MarkChuCarroll/instruments/README.md

# instruments
OpenSCAD models of musical instruments
