MarkChuCarroll/instruments/tenor/mtenor-out-fretboard-full.stl

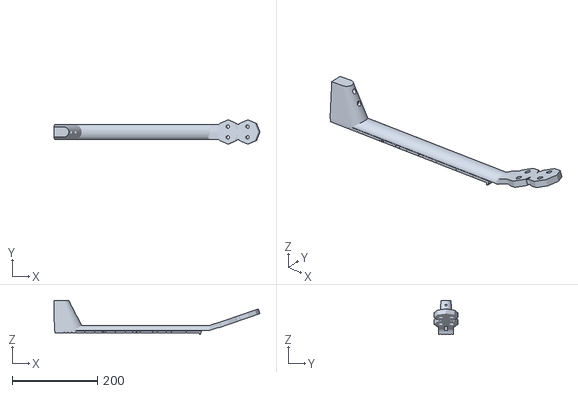
[picture p2: CAD file, 2025-11-11]
tenor/mtenor-out-fretboard-full.stl
484.5 x 56.0 x 80.5
