MarkChuCarroll/instruments/tenor/mtenor-out-assembled.stl

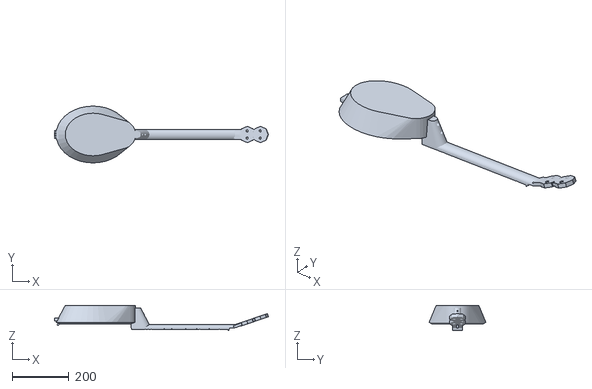
[picture p3: CAD file, 2025-11-11]
tenor/mtenor-out-assembled.stl
753.2 x 200.0 x 89.5
