MarkChuCarroll/instruments/tenor/mtenor-out-neck-a.stl

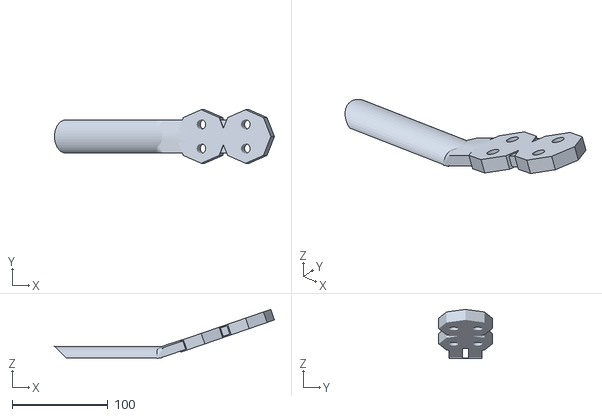
[picture p4: CAD file, 2025-11-11]
tenor/mtenor-out-neck-a.stl
230.0 x 56.0 x 51.5
