MarkChuCarroll/instruments/tenor/mtenor-out-bridge.stl

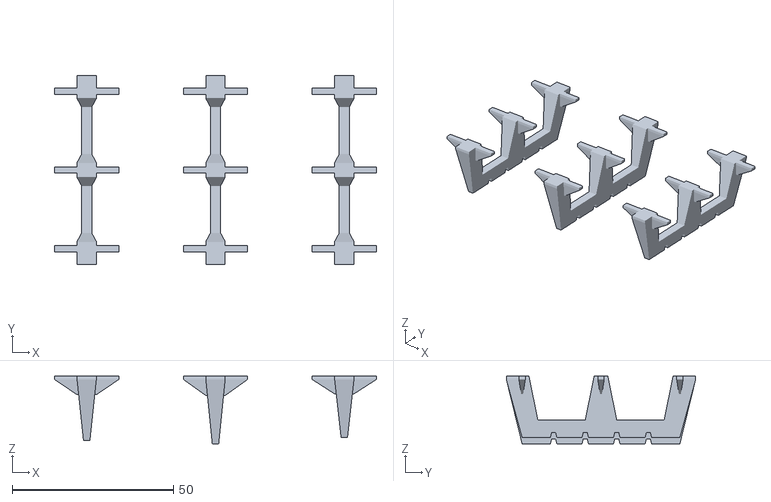
[picture p5: CAD file, 2025-11-11]
tenor/mtenor-out-bridge.stl
100.0 x 58.8 x 21.0
