MarkChuCarroll/instruments/tenor/mtenor-out-body-tail.stl

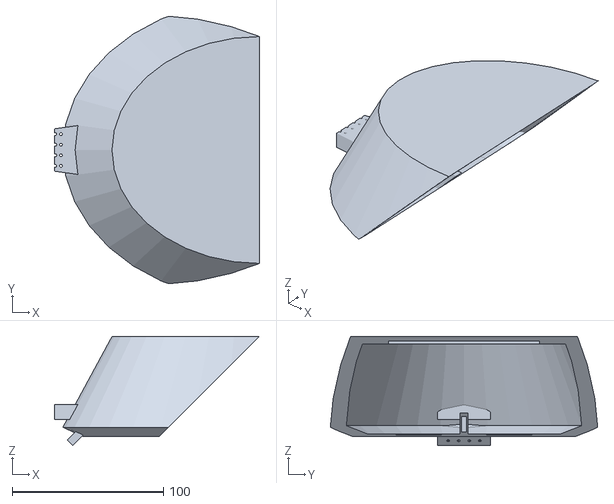
[picture p6: CAD file, 2025-11-11]
tenor/mtenor-out-body-tail.stl
135.5 x 176.8 x 72.1
