MarkChuCarroll/instruments/tenor/mtenor-out-body-neck.stl

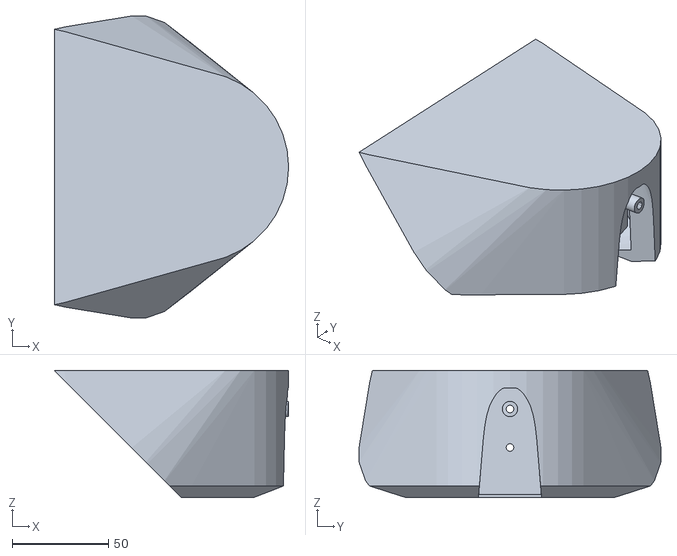
[picture p7: CAD file, 2025-11-11]
tenor/mtenor-out-body-neck.stl
121.7 x 156.9 x 66.0
