MarkChuCarroll/instruments/tenor/mtenor-out-body-center.stl

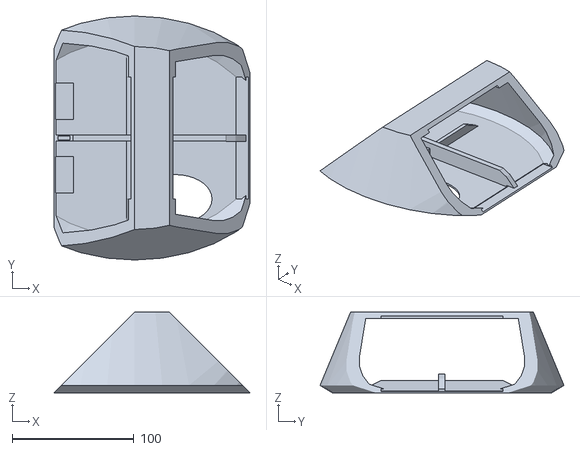
[picture p8: CAD file, 2025-11-11]
tenor/mtenor-out-body-center.stl
160.3 x 200.0 x 66.0
