MarkChuCarroll/instruments/tenor/mtenor-out-misc_bits.stl

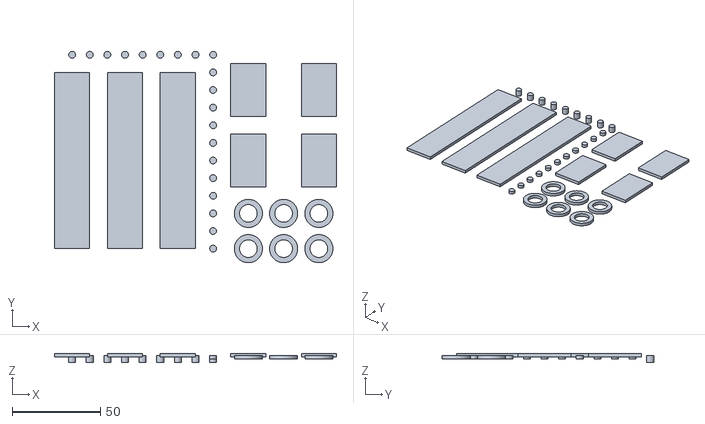
[picture p9: CAD file, 2025-11-11]
tenor/mtenor-out-misc_bits.stl
160.0 x 120.0 x 5.00
