MarkChuCarroll/instruments/tenor/mtenor-out-fretboard-a.stl

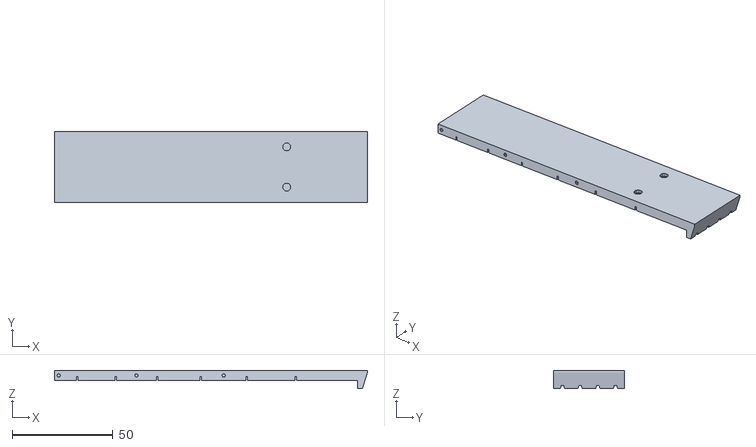
[picture p10: CAD file, 2025-11-11]
tenor/mtenor-out-fretboard-a.stl
155.0 x 35.0 x 9.00
