MarkChuCarroll/instruments/tenor/mtenor-out-neck-c.stl

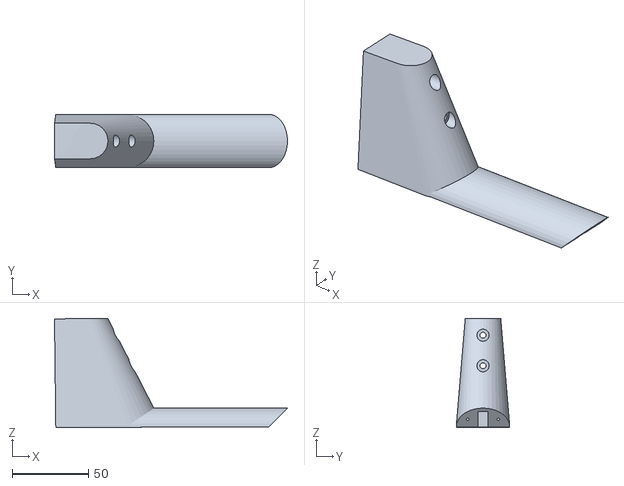
[picture p11: CAD file, 2025-11-11]
tenor/mtenor-out-neck-c.stl
152.7 x 35.0 x 71.5
