MarkChuCarroll/instruments/tenor/mtenor-out-neck-b.stl

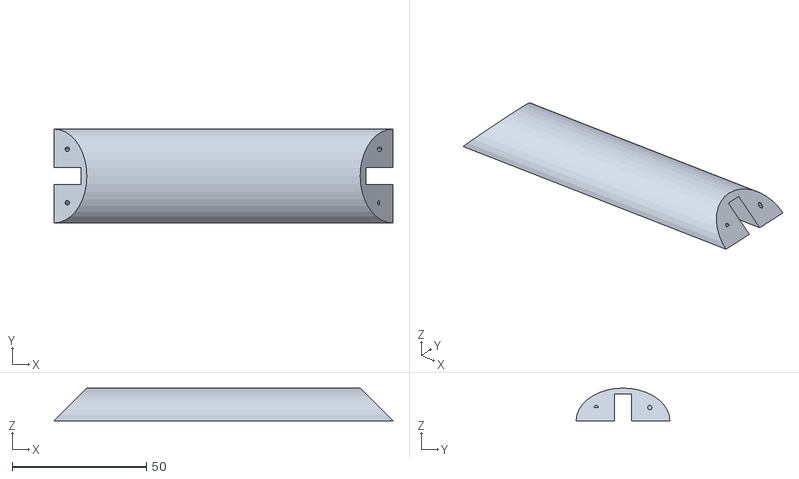
[picture p12: CAD file, 2025-11-11]
tenor/mtenor-out-neck-b.stl
126.4 x 35.0 x 12.2
