MarkChuCarroll/instruments/tenor/mtenor-out-fretboard-b.stl

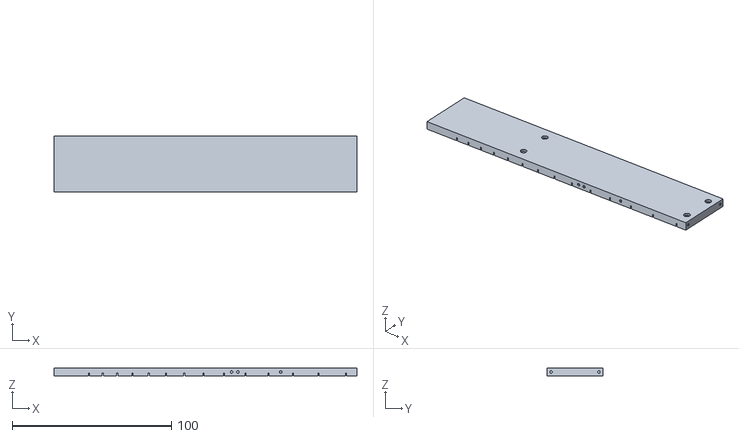
[picture p13: CAD file, 2025-11-11]
tenor/mtenor-out-fretboard-b.stl
190.1 x 35.0 x 5.00
