MarkChuCarroll/instruments/tenor/mtenor-out-lower-fretboard.stl

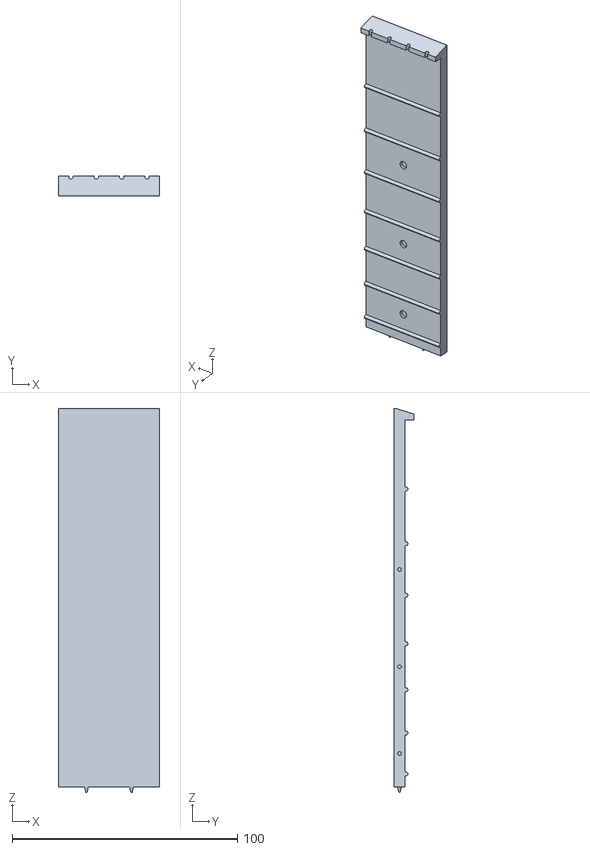
[picture p14: CAD file, 2025-02-17]
tenor/mtenor-out-lower-fretboard.stl
45.0 x 9.00 x 170.4
