MarkChuCarroll/instruments/tenor/bosl-tenor.scad

//
// Copyright 2024 Mark C. Chu-Carroll
//
// Licensed under the Apache License, Version 2.0 (the "License");
// you may not use this model except in compliance with the License.
// You may obtain a copy of the License at
//
//     http://www.apache.org/licenses/LICENSE-2.0
//
// Unless required by applicable law or agreed to in writing, software
// distributed under the License is distributed on an "AS IS" BASIS,
// WITHOUT WARRANTIES OR CONDITIONS OF ANY KIND, either express or implied.
// See the License for the specific language governing permissions and
// limitations under the License.

include <BOSL2/std.scad>

/**
 * The body is teardrop shaped. It's built by setting up two
 * cylinders, one smaller than the other, with offset centers,
 * and then taking their hull. We add a bit of slant by making
 * the larger cylinder actually a bit conic, but square up at
 * the heel because the smaller is a true cylinder.
 * Then we round the edges by using minkowski sum with a little sphere.
 */

module body(size, thickness, split = false) {
  module body_shape(length, thickness) {
    // Anchoris the body top where the neck meets the body.
    //  translate([ 130, 0, -5 ])
    //  minkowski() {
    module outline() {
      hull() {
        scale([ 1.3, 1, 1 ]) {
          cylinder(thickness + 10, length, length * 3 / 4);
        }
        translate([ length, 0, 0 ]) {
          cylinder(thickness + 10, length / 2, length / 2);
        }
      }
    }

    translate([ 0, 0, -5 ]) {
      hull() {
        outline();
        translate([ 0, 0, -10 ]) scale([ 0.9, 0.9, 0.9 ]) outline();
      }
    }
  }

  /**
   * The screwblock is a section matching the back end of the neck's heel
   * block, which has holes and hex-nut slots to allow the neck to be
   * securely bolted on to the body.
   */
  module screwblock(radius, length, thickness) {
    /*
     * I want to put cutouts for hex nuts into the screw block.
     * For an m4 hex nut, the size flat-to-flat is 7mm.
     * So the rough outer radius of the hexnut is 5mm.
     */
    module hexnut_slot() {
      rotate([ 90, 0, 0 ]) {
        rotate([ 0, 0, 30 ]) {
          union() {
            translate([ 0, 0, 20 ]) {
              cylinder(40, 2.4, 2.4, center = true, $fn = 20);
            }
            linear_extrude(height = 3) { circle(5, $fn = 6); }
          }
        }
      }
    }

    // positions for the holes are 8mm from the base of the neck heel,
    // and 25mm from the base of the neck heel.
    // The neck heal is ??? mm off the bottom of the body.
    translate([ size * 1.2 + 14, 0, thickness * 0.8 + 5 ])
        rotate([ 0, 180, 90 ]) {
      elev = thickness * 0.8 + 5 + 1;

      difference() {
        linear_extrude(thickness + 11, scale = [ 1.5, 1 ], center = false) {
          translate([ -radius, 0, 0 ]) { square([ radius * 2, length / 2 ]); }
        }
        // formerly 16.8 and 28.8
        translate([ 0, length / 2, elev - 8 ]) hexnut_slot();
        translate([ 0, length / 2, elev - 25 ]) hexnut_slot();
      }
    }
  }

  module assembly() {
    union() {
      /**
       * We want the body to be hollow. So what we do is create
       * one copy of the body  form, and then a second scaled version that's a
       * bit smaller - and we subtract the smaller one from the larger.
       */

      difference() {
        body_shape(size, thickness);
        translate([ 0, 0, 1 ]) {
          scale([ 0.9, 0.9, 0.9 ]) { body_shape(size, thickness); }
        }

        // cut out the sound-hole.
        // TODO: don't cut so far down; it's cutting into the body side.
        move([ size / 2.0 - 5, -size / 2 + 5, -thickness / 2 ]) {
          scale([ 1.4, 1.0, 1.0 ]) { cylinder(size / 4, size / 4, size / 4); }
        }

        translate([ 0, 0, -20 ]) neck(neck_offset, scale, neck_width, true);
      }

      translate([ -20, 0, 0 ]) screwblock(neck_width * 2 / 6, 20, 45);

      // and the tailpiece.
      up(thickness / 3) left(size * 1.1) tapered_tailpiece(
          neck_width, neck_width / 4, neck_width / 1.5, neck_width / 6);

      // The string guide over the tailpiece.
      color("#ff00ff") translate([ -size * 1.25, 0, -12 ]) rotate([ 0, 45, 0 ])
          cuboid([ 2, neck_width * 1.2, 14 ], chamfer = 1);

      // internal bracing
      // CF rod is 1/8x3/8 - which is 3.175mmx9.525mm. Adding a bit of space
      // so that it can be slid in, we can make a slot that's 3.5mmx10mm.
      difference() {
        union() {
          down(12) color("#ff0000") prismoid([ 10, 155 ], [ 10, 120 ], 6);
          zrot(90) down(12) fwd(100) left(6) cube([ 12, 200, 15 ]);
        }
        zrot(90) down(7) fwd(95) left(3.5 / 2) cube([ 3.5, 190, 10 ]);

        // prismoid([ 12, 200 ], [ 10, 150 ], 15);
        // prismoid([ 3.5, 200 ], [ 3.5, 150 ], 10);
      }
    }
  }

  assembly();
}

/*
 * The neck gets pretty complicated.
 * We start with a half cylinder of the right length. To get the cross
 * section that we want, we then stretch its width by 1.3, and its
 * height and 1.2.
 *
 * Then we add the head. It'll probably get tweaked a bit to make it
 * prettier, but for now, it's a box set at a 20 degree declination
 * from the next, rounded at the back.
 *
 * Next, we add a heel, which I moved into another module.
 *
 * After the heel, we'll add the nut up at the top of the neck.
 *
 * Right next to the nut will be the fingerboard, with fret slots. (I
 * strongly prefer real  metal frets, so I'm just using slots, not
 * creating printed frets.
 */
module neck(offset, scale, width, solid = false) {
  neck_length = scale - offset;
  thickness = width / 2;

  /*
   * For creating the neck, it'll make things easier to start
   * with a half-cylinder.
   */
  module half_cylinder(radius, length) {
    union() {
      difference() {
        rotate([ 0, 90, 0 ]) { cylinder(length, radius, radius); }
        translate([ 0, -radius, -radius ]) {
          cube([ length * 3, radius * 2, radius ]);
        }
      }
    }
  }

  module neck_blank(width, length) {
    scale([ 1, 1.0, 0.8 ]) { half_cylinder(width / 2.0, length); }
  }

  module trussrod_cutout(length, neckwidth) {
    one_eighth_inch = 25.4 / 8;
    three_eighths_inch = 3 * one_eighth_inch;
    one_quarter_inch = one_eighth_inch * 2;
    one_sixteenth_inch = one_eighth_inch / 2;
    five_sixteenths_inch = 5 * one_sixteenth_inch;
    union() {
      // The main trussrod slot, running the full length of the neck.
      translate([ 0, -one_eighth_inch, -20 ])
          cube([ length, one_quarter_inch, three_eighths_inch + 20 ]);

      // The trussrod gets a little bit wider at the top, where the
      // screw mechanism is, so we need to broaden the cutout just
      // a little bit.
      translate([ length - 45, -three_eighths_inch / 2, -18 ]) {
        cube([ 45, three_eighths_inch, three_eighths_inch + 22 ]);
      }
      // And to reduce stress concentration, add a transition
      // between the wider and narrower parts.
      translate([ length - 45 + 1, 0, -0.5 ]) {
        color("#008888") rotate([ 0, -90, 0 ])
            prismoid(size1 = [ 29, three_eighths_inch ],
                     size2 = [ 20, one_quarter_inch ], h = three_eighths_inch);
      }

      translate([ length, 0, 4 ]) {
        rotate([ 0, 90, 0 ]) {
          scale([ 1.2, 1.6, 1.0 ]) cylinder(40, neckwidth / 5, neckwidth / 8);
        }
      }
    }
  }

  module heel(radius, length, thickness, drill = true) {
    translate([ radius - 5, 0, thickness ]) difference() {
      rotate([ 180, 0, 0 ]) {
        difference() {
          linear_extrude(thickness, scale = [ 2.0, 1.5 ], center = false) {
            circle(radius) left(radius) square(radius * 2, thickness);
          }
          translate([ -6 * radius, -radius * 2, 0 ]) {
            cube([ radius * 4, radius * 4, thickness ]);
          }

          if (drill) {
            translate([ -20, 0, 8 ]) {
              rotate([ 0, 90, 0 ]) { cylinder(70, 2.4, 2.4, $fn = 20); }
            }
            translate([ 10, 0, 8 ]) {
              rotate([ 0, 90, 0 ]) { cylinder(30, 5, 5); }
            }

            translate([ -20, 0, 25 ]) {
              rotate([ 0, 90, 0 ]) { cylinder(70, 2.4, 2.4, $fn = 20); }
            }
            translate([ 12, 0, 25 ]) {
              rotate([ 0, 90, 0 ]) { cylinder(30, 5, 5); }
            }
          }
        }
      }
    }
  }

  /**
   * The headstock.
   *
   * This took a ton of time to get to the point where it looks
   * good, and it's also functional. It's basically shaped from
   * two overlapping octagons. It gets thicker and a bit faceted
   * as it comes close to the neck joint.
   */
  module headstock(length, width, thickness) {
    // Anchor point is the center edge of the round section where the
    // headstock meets the body.

    module oct(diam) {
      intersection() {
        square([ diam, diam ], center = true);
        rotate([ 0, 0, 45 ]) square([ diam, diam ], center = true);
      }
    }

    module shaped_head(width, thickness) {
      rotate([ 0, 0, 90 ]) {
        union() {
          back(10) left(10) down(2) mark(width / 4, 4);
          linear_extrude(thickness) {
            // Overlapp two of the octagons.
            oct(width);
            translate([ 0, 3 * width / 4, 0 ]) {
              scale([ 1.0, 1.0, 1.0 ]) oct(width);
            }
            //            // And then add in a rectangular segment to push them
            //            back. translate([ -width / 4, 5 * width / 4, 0 ]) {
            //              square([ width / 1.5, 20 ]);
            //            }
          }
        }
      }
      // for the area where the head meets the neck joint,
      // we create one half of an octagon, and hull it
      // with a cylinder
      scale([ 1.0, 1.0, 1.0 ]) translate([ -width * 3 / 4 - 20, 0, -2 ]) {
        //         translate([0, 0, 100]) {
        //         linear_extrude(height = thickness) {
        //              translate([ 0, -width / 3, 0 ]) square([ width / 1.5, 20
        //              ]);
        //         }
        //     }

        hull() {
          translate([ -width / 2 + 2, 0.5, thickness ]) rotate([ 90, 0, 0 ])
              cylinder(width * 0.68, thickness * 0.8, thickness * 0.8,
                       center = true);

          translate([ 0, 0, 0 ]) {
            linear_extrude(height = thickness / 2) {
              translate([ 0, -width / 5, 0 ]) square([ width / 3, 20 ]);
              //              oct(width);
              //              translate([ -width * 0.2, -width / 2 ]) square([
              //              width, width ]);
            }
          }
        }
      }
    }

    translate([ -78, -23, -38 ]) union() {
      translate([ width * 4.5, 0, thickness * 2 + 16 ]) {
        rotate([ 0, -20, 0 ]) {
          difference() {  // create the basic head shape, and then drill holes
                          // into it for the tuners. The tuners that I'm using
                          // require 10mm holes.
            shaped_head(width * 1.5, thickness / 2);
            // The x=5 here is totally pragmatic:  I thought it would be
            // -width/2, but in practice, that just wasn't the right location
            // - it wasn't centered properly, but adding a 5mm translation
            // fixed it.
            translate([ 5, 0, -5 ]) {
              translate([ 0, width / 3 ]) cylinder(30, 5, 5);
              translate([ 0, -width / 3 ]) cylinder(30, 5, 5);
            }
            translate([
              -width * 1, 0, -10
            ]) {  // And here, it's exactly as I expected.
              translate([ 0, width / 3 ]) cylinder(30, 5, 5);
              translate([ 0, -width / 3 ]) cylinder(30, 5, 5);
            }
          }
        }
      }
    }
  }

  translate([ 130, 0, -5 ]) union() {
    difference() {
      // First, we have main body of the neck, joined with the headstock and
      // heel.
      union() {
        neck_blank(width, neck_length);

        translate([ neck_length - 10, width / 1.8, 14 ])
            headstock(neck_length, width, thickness);
        heel(width / 3, 50, 55, !solid);
      }

      if (!solid) {
        // Then we cut in the slot for the truss rod, along with a matching
        // cutout in the headstock for truss-rod access.
        trussrod_cutout(neck_length, width);
      }
    }
  }
}

/**
 * The nut at the top of the neck. The height of the nut might need
 * to be tweaked to adjust the string action.
 */
module nut(width, height, thickness, offset) {
  module string_notch(width, depth, elev) {
    translate([ 10, 0, -elev ]) {
      rotate([ -90, 0, 90 ]) {
        linear_extrude(20) {
          polygon([ [ -width / 2, 0 ], [ width / 2, 0 ], [ 0, -depth ] ],
                  [[ 0, 1, 2 ]]);
        }
      }
    }
  }

  translate([ 0, width / 2, 0 ]) {
    difference() {
      rotate([ 0, 180, 180 ]) {
        linear_extrude(thickness, scale = [ 0.7, 1.0 ]) {
          square([ height, width ]);
        }
      }

      // String notches
      dist = (width - 2 * offset) / 3;
      translate([ 0, -offset - (dist * 0), 0 ]) {
        string_notch(width = 2, depth = 3, elev = thickness + 1.0);
      }
      translate([ 0, -offset - (dist * 1), 0 ]) {
        string_notch(width = 2, depth = 3, elev = thickness + 0.5);
      }
      translate([ 0, -offset - (dist * 2), 0 ]) {
        string_notch(width = 2, depth = 3, elev = thickness);
      }
      translate([ 0, -offset - (dist * 3), 0 ]) {
        string_notch(width = 2, depth = 3, elev = thickness);
      }
    }
  }
}

/**
 * The fingerboard, with fret slots cut into it. Personally,
 * I prefer to use real metal fret wire for frets, so instead of
 * shaping frets into the pattern, I cut out slots to insert fret
 * wire.
 */
module fingerboard(length, width, scale, num_frets) {
  module dot(fret, offset) {
    dot_size = width / 16;

    color("#ff0000") translate([
      fret_position(length + 100, fret - 1) +
          fret_distance(length + 100, fret) / 2 - 100,
      offset, -2
    ]) {
      cylinder(4, dot_size, dot_size);
    }
  }
  module side_dot(fret, offset) {
    translate([
      fret_position(length + 100, fret - 1) +
          fret_distance(length + 100, fret) / 2 - 100 + offset,
      2, 2
    ]) {
      rotate([ 90, 0, 0 ]) { cylinder(4, 0.7, 0.7); }
    }
  }
  module single_dot(fret) {
    dot(fret, width / 2);
    side_dot(fret, 0);
  }
  module double_dot(fret) {
    fd = fret_distance(length + 100, fret);
    dot(fret, width / 4);
    dot(fret, 3 * width / 4);
    side_dot(fret, fd / 8);
    side_dot(fret, -fd / 8);
  }

  // given a scale length L, fret N is positioned
  // L/(2^1/12) from the bridge.
  C = 2 ^ (1 / 12);
  function fret_position(L, n) = L / (C ^ n);
  function fret_distance(L, n) = fret_position(L, n) - fret_position(L, n - 1);
  color("#0000ff") {
    difference() {
      cube([ length - 5, width, 4 ]);

      for (i = [1:num_frets]) {
        translate([ fret_position(length + 100, i) - 100, -width / 2, -2 ]) {
          cube([ 1, 100, 4 ]);
        }
      }
      single_dot(3);
      single_dot(5);
      single_dot(7);
      single_dot(10);
      double_dot(12);
    }
  }

  // dot markers:
  // single at 3, 5, 7, 10,
  // double at 12
}

module split_fingerboard(length, width, scale, num_frets, head = true,
                         heel = true) {
  module heel_with_studs() {
    union() {
      difference() {
        fingerboard(length, width, scale, num_frets);
        translate([ length / 2, -5, -2 ]) {
          cube([ 200, 50, 20 ], center = false);
        }
      }
      translate([ length / 2.0, width / 6, 2 ]) {
        rotate([ 0, 90, 0 ]) cylinder(4, 1.5, 1);
      }
      translate([ length / 2.0, width * 5 / 6, 2 ]) {
        rotate([ 0, 90, 0 ]) cylinder(4, 1.5, 1);
      }
    }
  }

  module head_with_sockets() {
    difference() {
      fingerboard(length, width, scale, num_frets);
      heel_with_studs();
    }
  }

  if (heel) {
    heel_with_studs();
  }
  if (head) {
    translate([ 20, 0, 0 ]) { head_with_sockets(); }
  }
}

module tapered_tailpiece(width, thickness, depth, border) {
  difference() {
    minkowski() {
      rotate([ -90, 0, 90 ]) linear_extrude(depth, scale = [ 0.8, 0.6 ])
          square([ width, thickness ], center = true);
      // cube([ depth, width, 10 ], center = true);
      sphere(depth / 10);
    }
    hole_zone = width - 2 * border;
    hole_sep = hole_zone / 3;
    for (s = [0:3]) {
      pos = (-hole_zone / 2) + (s * hole_sep);
      translate([ -(depth * 3 / 4), pos, -20 ]) { cylinder(40, 2, 2); }
      translate([ -depth - 2, pos, -20 ]) { cylinder(40, 2, 2); }
    }
  }
}

module bridge(width, height) {
  translate([ 0, 0, -height * 2 ]) {
    difference() {
      union() {
        // main section
        color("#ff0000")
            linear_extrude(height, scale = [ 3, 1.3 ], center = false) {
          square([ 2, neck_width ], center = true);
        }
        // 3 bottom foot/wedges
        up(height / 2)
            prismoid(size1 = [ 2, 2 ], size2 = [ 15, 2 ], height = height / 2);
        fwd(width / 2.2) up(height / 2)
            prismoid(size1 = [ 2, 2 ], size2 = [ 15, 2 ], height = height / 2);

        back(width / 2.2) up(height / 2)
            prismoid(size1 = [ 2, 2 ], size2 = [ 15, 2 ], height = height / 2);
      }

      fwd(width / 4) up(height) zrot(90) yrot(180)
          prismoid([ width / 4, height ], [ width / 8, height ], height * 0.6);

      back(width / 4) up(height) zrot(90) yrot(180)
          prismoid([ width / 4, height ], [ width / 8, height ], height * 0.6);

      edge = width / 5;
      dist = (width - 2 * edge) / 3;
      for (n = [0:3]) {
        back(width / 2 - (edge + n * dist)) prismoid([ 5, 1.5 ], [ 5, .75 ], 1);
      }
    }
  }
}

module tenor_guitar(size = 80, separated = false, make_body = true,
                    make_fingerboard = true, make_neck = true,
                    make_bridge = true) {
  fingerboard_layout_offset = separated ? -200 : 0;
  neck_layout_offset = separated ? -400 : 0;
  union() {
    if (make_body) {
      body(size, size * 3 / 8, separated);
    }
    if (make_neck) {
      fwd(neck_layout_offset) translate([ 0, 0, -18 ]) {
        neck(neck_offset, scale, neck_width);
      }
      translate([ scale + 5, 0, -22 ])
          nut(neck_width, neck_width / 8, neck_width / 5, neck_width / 9);
    }

    if (make_fingerboard) {
      fwd(fingerboard_layout_offset) translate([ 110, -neck_width / 2, -26 ])
          fingerboard(scale - neck_offset, neck_width, scale, 20);

      if (separated) {
        for (i = [0:6]) {
          translate([ scale - 100 - i * 10, 0, 0 ]) color("#ff0000")
              cylinder(2, neck_width / 16, neck_width / 16);
        }
      }
    }
  }

  if (make_bridge) {
    fwd(fingerboard_layout_offset) translate([ -size / 2, 0, 5 ]) {
      bridge(neck_width, 17);
    }
  }
}

// My maker's mark.
module mark(size, thickness) {
  w = size;
  h = 6 * size / 5;

  line = w / 12;

  // Left leg of the M
  union() {
    cube([ line, h, thickness ]);
    cube([ w / 4, line, thickness ]);
  }

  union() {
    zrot(180) right(-w / 4) fwd(h) {
      cube([ line, h * 3 / 4, thickness ]);
      cube([ w / 8, line, thickness ]);
    }
  }

  // Right leg
  right(w) union() {
    cube([ line, h, thickness ]);
    left(w / 4 - line) cube([ w / 4, line, thickness ]);
  }
  right(3 * w / 4 - line) union() {
    right(w / 8 + line / 2) zrot(180) fwd(h) xflip() {
      cube([ line, h * 3 / 4, thickness ]);
      cube([ w / 8, line, thickness ]);
    }
  }

  // center V
  right(w / 2 + line / 2) back(h / 2.1) scale([ 1, 1.2, 1 ]) {
    zrot(-135) {
      union() {
        cube([ w / 2.2, line, thickness ]);
        cube([ line, w / 2.2, thickness ]);
      }
    }
  }

  // Left C
  cheight = h / 2.5;
  up(thickness / 2) back(h * 3 / 4) right(w / 4 + line) yrot(90) zrot(90) {
    difference() {
      prismoid([ cheight / 1.5, thickness ], [ cheight, thickness ], w / 5);
      up(w / 12) prismoid([ cheight / 3, thickness ],
                          [ cheight / 2, thickness ], w / 10);
    }
  }

  // Right C
  up(thickness / 2) back(h * 3 / 4) right(w * 3 / 4 - 2 * line) yrot(90)
      zrot(90) difference() {
    difference() {
      prismoid([ cheight / 1.5, thickness ], [ cheight, thickness ], w / 5);
      up(w / 12) prismoid([ cheight / 3, thickness ],
                          [ cheight / 2, thickness ], w / thickness);
    }
  }
}

module split_body(size, neck = true, tail = true) {
  module with_studs() {
    union() {
      difference() {
        body(size, size * 3 / 8, true);
        rotate([ 0, 45, 0 ]) translate([ -size * 3 / 16, -100, -100 ])
            cube([ 200, 200, 300 ]);
      }
      //      translate([ -20, 0, -6 ]) rotate([ 0, -90, 0 ])
      //      cylinder(8, 1.8, 2.5);
      translate([ -30.0, -85, -8 ]) rotate([ 0, -90, 0 ]) cylinder(8, 1.8, 2.5);
      translate([ -30, 85, -8 ]) rotate([ 0, -90, 0 ]) cylinder(8, 1.8, 2.5);
      translate([ 18, -70, 40 ]) rotate([ 0, -90, 0 ]) cylinder(8, 1.8, 2.5);
      translate([ 18, 70, 40 ]) rotate([ 0, -90, 0 ]) cylinder(8, 1.8, 2.5);
      // A bit of alignment plate for glue-up
      left(45) fwd(50) down(13) cube([ 20, 40, 2 ]);
      left(45) back(20) down(13) cube([ 20, 40, 2 ]);
    }
  }

  module with_sockets() {
    difference() {
      body(size, size * 3 / 8, true);
      with_studs();
    }
  }

  if (tail) {
    translate([ -50, 0, 0 ]) { with_studs(); }
  }
  if (neck) {
    translate([ 50, 0, 0 ]) { with_sockets(); }
  }
}

module split_neck(neck_offset, scale_length, neck_width, head = true,
                  heel = true) {
  module with_studs() {
    union() {
      difference() {
        neck(neck_offset, scale_length, neck_width);
        translate([ (scale_length - neck_offset) / 2 + 50, -100, -100 ])
            rotate([ 0, 45, 0 ]) cube([ 200, 200, 500 ]);
      }
      translate([
        neck_offset + (scale_length - neck_offset) / 2 + 60, -neck_width / 4,
        neck_width / 8
      ]) rotate([ 0, -80, 0 ]) cylinder(8, 1.8, 2.5);
      translate([
        neck_offset + (scale_length - neck_offset) / 2 + 60, neck_width / 4,
        neck_width / 8
      ]) rotate([ 0, -80, 0 ]) cylinder(8, 1.8, 2.5);
    }
  }

  module with_sockets() {
    difference() {
      neck(neck_offset, scale_length, neck_width);
      with_studs();
    }
  }
  if (heel) {
    translate([ -50, 0, 0 ]) with_studs();
  }
  if (head) {
    translate([ 50, 0, 0 ]) with_sockets();
  }
}

/**
 * I want a scale length of about 18 inches.
 * The bridge should be about 3 inches from the tail - so the
 * body from bridge to neck will be about 5 3/4 inches, leaving us a
 * neck length of 12 1/4 inches.
 */
scale = 18 * 25.4;
neck_offset = 100;
neck_width = 40;

AUTO = true;
ALL = 0;
NECK_HEAD = 1;
NECK_HEEL = 2;
BODY_NECK = 3;
BODY_TAIL = 4;
FINGERBOARD_HEAD = 5;
FINGERBOARD_HEEL = 6;
BRIDGE = 7;
NUT = 8;

// For driving this from the command line:
make_part = 0;

if (AUTO) {
  if (make_part == ALL) {
    tenor_guitar(100);
  }
  if (make_part == NECK_HEAD) {
    split_neck(neck_offset, scale, neck_width, head = true, heel = false);
  } else if (make_part == NECK_HEEL) {
    split_neck(neck_offset, scale, neck_width, head = false, heel = true);
  } else if (make_part == BODY_NECK) {
    split_body(100, neck = true, tail = false);
  } else if (make_part == BODY_TAIL) {
    split_body(100, neck = false, tail = true);
  } else if (make_part == FINGERBOARD_HEAD) {
    split_fingerboard(scale - neck_offset, neck_width, scale, 20, head = true,
                      heel = false);
  } else if (make_part == FINGERBOARD_HEEL) {
    split_fingerboard(scale - neck_offset, neck_width, scale, 20, head = false,
                      heel = true);
  } else if (make_part == BRIDGE) {
    bridge(neck_width, 14);
    translate([ 50, 0, 0 ]) { bridge(neck_width, 12); }
    translate([ 100, 0, 0 ]) { bridge(neck_width, 11); }
  } else if (make_part == NUT) {
    nut(neck_width, neck_width / 9.0, neck_width / 6.0, neck_width / 9.0);
    translate([ 50, 0, 0 ])
        nut(neck_width, neck_width / 9.0, neck_width / 7.0, neck_width / 9.0);
  } else {
    tenor_guitar(100);
  }
} else {
  //  neck(neck_offset, scale, neck_width);

  split_body(100, neck = true);
}
