MarkChuCarroll/instruments/(commit log)

2024-06-25 Initial version of a SCAD model for a miniature tenor guitar.
    [gitty.scad]
2024-06-26 Refined the design, added holes and nutslots for bolt-on neck.
    [tenor.scad]
2024-06-29 Redid the basic design using BOSL2 to make it cleaner. Redid the bridge.
    Still lots of stuff I could do with BOSL2 - but I'm just
    learning, and I'm pretty happy with this design as is.
    [bosl-tenor.scad, tenor.scad]
2024-07-03 Set up printable STLs.
    [assembled-tenor.stl, bosl-tenor-body-part-one.stl, bosl-tenor-body-part-two.stl, bosl-tenor.scad, fingerboard-bridge-and-nut.stl, neck-head.stl, neck-heel.stl, tenor.scad]
2024-07-07 Fix the neck proportions, and various alignments.
    [bosl-tenor.scad]
2024-07-12 Adjusting the trussrod cutout to match the actual contours of the trussrod.
    [assembled-tenor.stl, bosl-tenor-body-part-one.stl, bosl-tenor-body-part-two.stl, bosl-tenor.scad, fingerboard-bridge-and-nut.stl, neck-head.stl, neck-heel.stl]
2024-07-12 Updated to match the latest version I released on thingiverse and printables.
    [bosl-tenor.scad, tenor-parts-body_neck.stl, tenor-parts-body_tail.stl, tenor-parts-bridge.stl, tenor-parts-fb_head.stl, tenor-parts-fb_heel.stl, tenor-parts-neck_head.stl, tenor-parts-neck_heel.stl]
2024-07-12 Added space for carbon fiber rod, plus string support at the tail.
    [bosl-tenor.scad]
2024-10-08 Small tweaks.
    [bosl-tenor.scad, tenor-parts-body_neck.stl, tenor-parts-body_tail.stl, tenor-parts-bridge.stl, tenor-parts-fb_head.stl, tenor-parts-fb_heel.stl, tenor-parts-neck_head.stl, tenor-parts-neck_heel.stl]
2025-01-29 Revamping for v2.
    [bosl-tenor.scad]
2025-02-04 Updated the old openscad model, and started on a new one in simplex.
    [bosl-tenor.scad]
2025-02-08 Continuing to refine the simplex version of the guitar. The basic shape of the neck is just about right, and the truss-rod slot is cut.
    Still needs a fingerboard, the holes for the tuner, and
    the holes for the neck mounting screws.
    [bosl-tenor.scad]
2025-02-09 Added a screwblock, screwholes, and hexnut slots to the body.
2025-02-17 Split neck with pegs.
    [mtenor-out-assembled.stl, mtenor-out-body-left.stl, mtenor-out-body-right.stl, mtenor-out-lower-fretboard.stl, mtenor-out-neck-a.stl, mtenor-out-neck-b.stl, mtenor-out-neck-c.stl, mtenor-out-upper-fretboard.stl]
2025-02-18 Complete, printable model of the guitar!
    [mtenor-out-body-a.stl, mtenor-out-body-b.stl, mtenor-out-fretboard-a.stl, mtenor-out-fretboard-b.stl, mtenor-out-upper-fretboard.stl]
2025-02-20 Added the bridge and the fretboard dots, and refined the string notches in the nut on the fretboard.
    [mtenor-out-fretboard-a.stl]
2025-03-22 Updated for slightly different neck size, and using filament for alignment pegs.
    [mtenor-out-assembled.stl, mtenor-out-body-a.stl, mtenor-out-body-b.stl, mtenor-out-fretboard-a.stl, mtenor-out-fretboard-b.stl, mtenor-out-neck-a.stl, mtenor-out-neck-b.stl, mtenor-out-neck-c.stl]
2025-03-28 Thickened the soundboard, and re-divided the body into 3 parts instead of 2.
    [mtenor-out-assembled.stl, mtenor-out-body-a.stl, mtenor-out-body-b.stl]
2025-11-11 I'm calling this v3.0.
    This is by far the best instrument so far.
    * for the first time, this one can be strung with either
    extra-light or light metal strings, and it holds intonation
    for days.
    * The fretting is in tune and playable, with one exception
    The C string, first fret tunes high, because the string is
    too thick for the slot, so it sits high, and then gets
    stretched when it's fretted, playing nearly 1/2 step
    sharp. I believe that this can be fixed by a combination
    of making the slot a bit wider, and cutting it in a bit
    deeper.
    [mtenor-out-assembled.stl, mtenor-out-fretboard-a.stl, mtenor-out-fretboard-b.stl, mtenor-out-neck-a.stl, mtenor-out-neck-b.stl, mtenor-out-neck-c.stl]
2025-11-11 Narrowed the neck; improved the profile of the notches in the fretboard nut.
    [mtenor-out-assembled.stl, mtenor-out-fretboard-a.stl, mtenor-out-fretboard-b.stl, mtenor-out-neck-a.stl, mtenor-out-neck-b.stl, mtenor-out-neck-c.stl]
2025-11-11 modified the heel to make it match the narrower neck profile.
    [mtenor-out-assembled.stl, mtenor-out-fretboard-a.stl, mtenor-out-neck-a.stl, mtenor-out-neck-b.stl, mtenor-out-neck-c.stl]
2025-11-11 Remove the alignment pins.
    The pins aren't needed anymore, since I added the
    alignment plates for gluing up.
2025-11-11 Fix positioning of the updated slots in the nut and bridge.
    [mtenor-out-assembled.stl, mtenor-out-fretboard-a.stl]
2025-11-11 Re-arrange the products to put misc bits on a single plate.
    [mtenor-out-body-center.stl, mtenor-out-body-neck.stl, mtenor-out-body-tail.stl, mtenor-out-bridge.stl, mtenor-out-fretboard-full.stl, mtenor-out-misc_bits.stl]
2025-11-11 Reposition the tuning pegs.
    [mtenor-out-assembled.stl, mtenor-out-fretboard-full.stl, mtenor-out-neck-a.stl]
